majorlongval/first_article_doc/documents_latex/Capstan_drive_ASME/images/3d_print.png

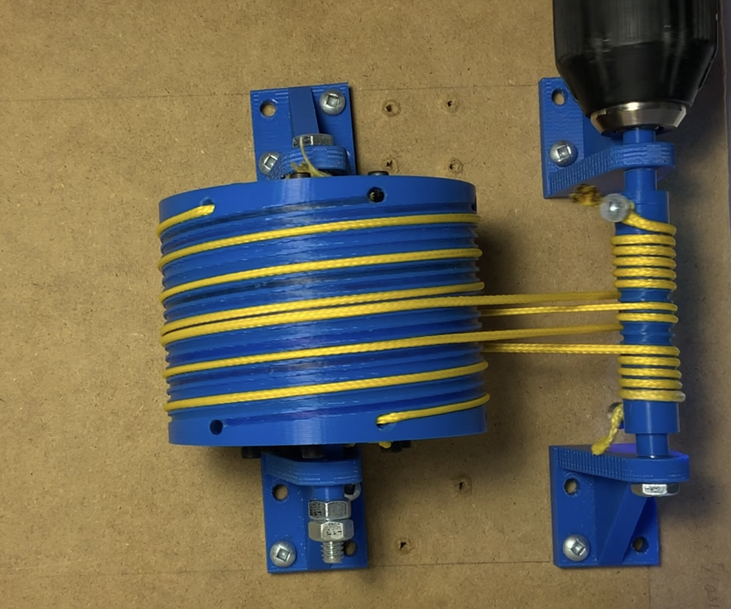
documents_latex/Capstan_drive_ASME/images/3d_print.png
