majorlongval/first_article_doc/documents_latex/Capstan_drive_ASME/images/alt_robot_arch.PNG

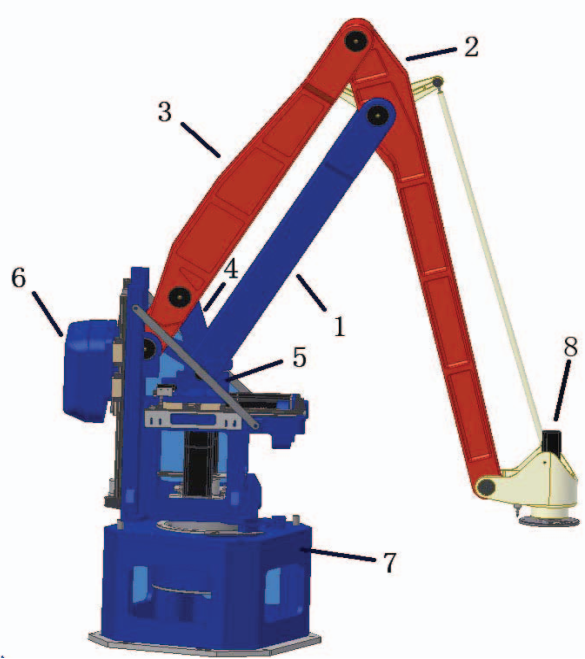
documents_latex/Capstan_drive_ASME/images/alt_robot_arch.PNG
