majorlongval/first_article_doc/documents_latex/Capstan_drive_ASME/images/proto_keifei.PNG

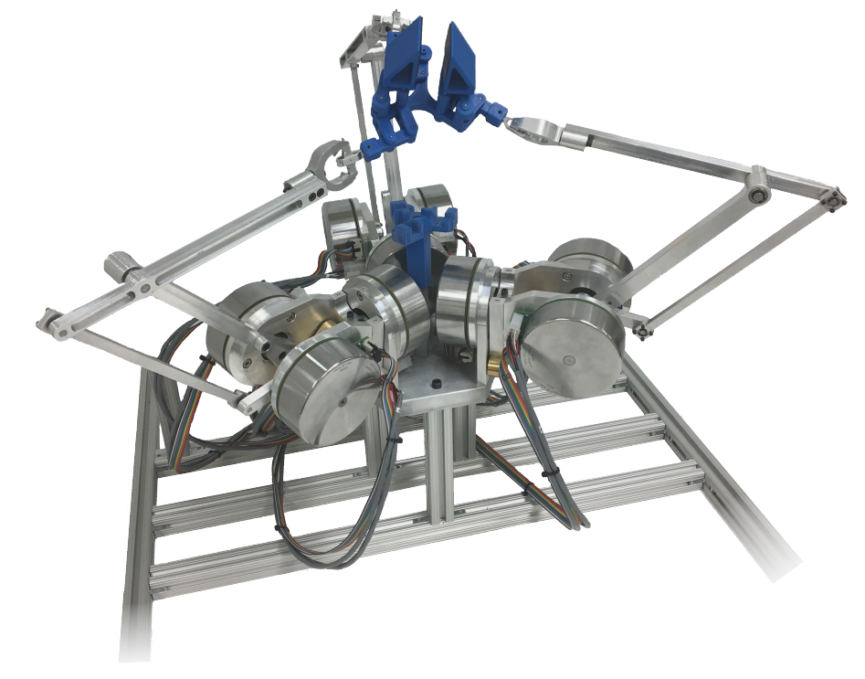
documents_latex/Capstan_drive_ASME/images/proto_keifei.PNG
