majorlongval/first_article_doc/documents_latex/Capstan_drive_ASME/images/wen7-0331-hires.gif

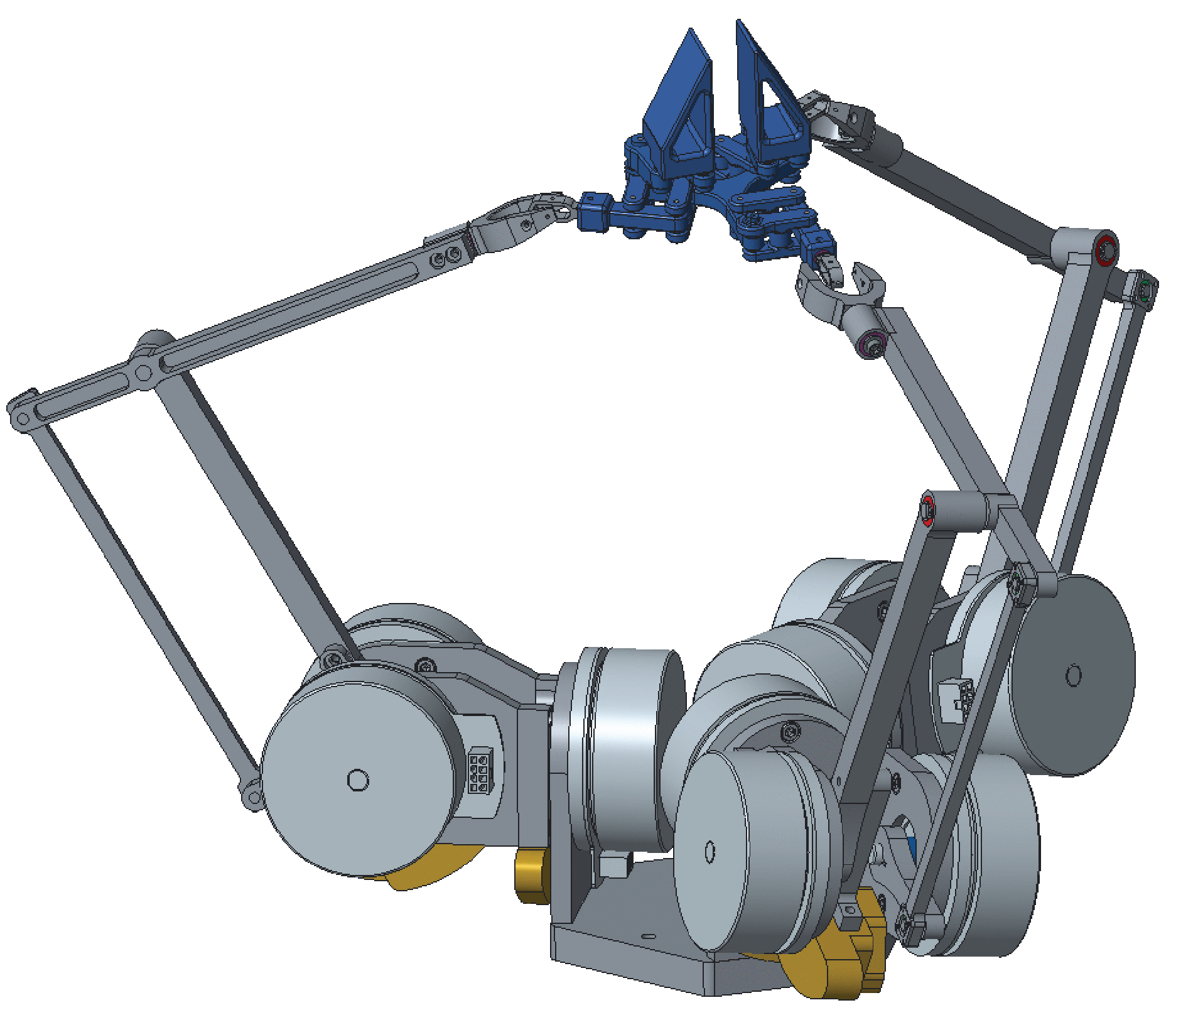
documents_latex/Capstan_drive_ASME/images/wen7-0331-hires.gif
