majorlongval/first_article_doc/CAD_files/rouleau_rainure_simple.stl

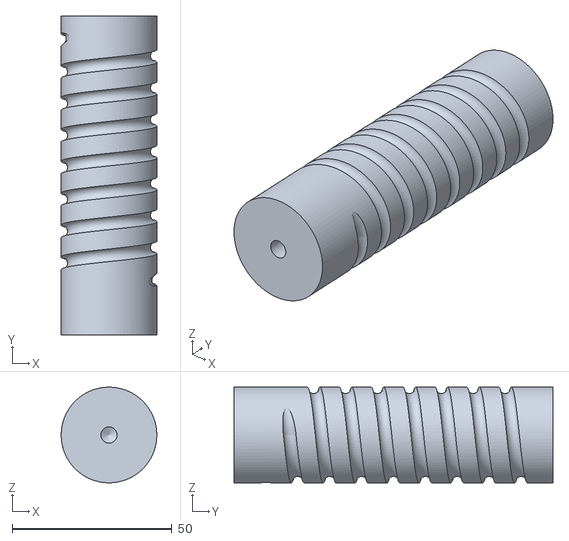
[picture p6: CAD file, 2021-09-30]
CAD_files/rouleau_rainure_simple.stl
30.0 x 100.0 x 30.0
