majorlongval/first_article_doc/CAD_files/rouleau_base_v3.stl

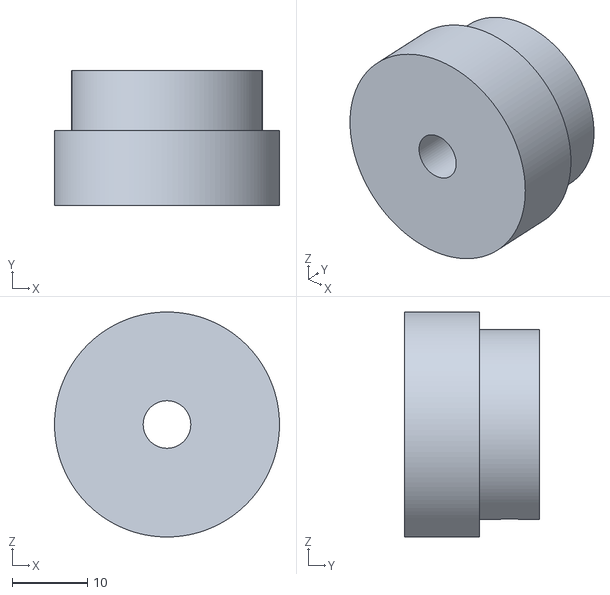
[picture p7: CAD file, 2021-09-30]
CAD_files/rouleau_base_v3.stl
30.0 x 18.0 x 30.0
