majorlongval/first_article_doc/CAD_files/rouleau_rainure_complexe_v2.stl

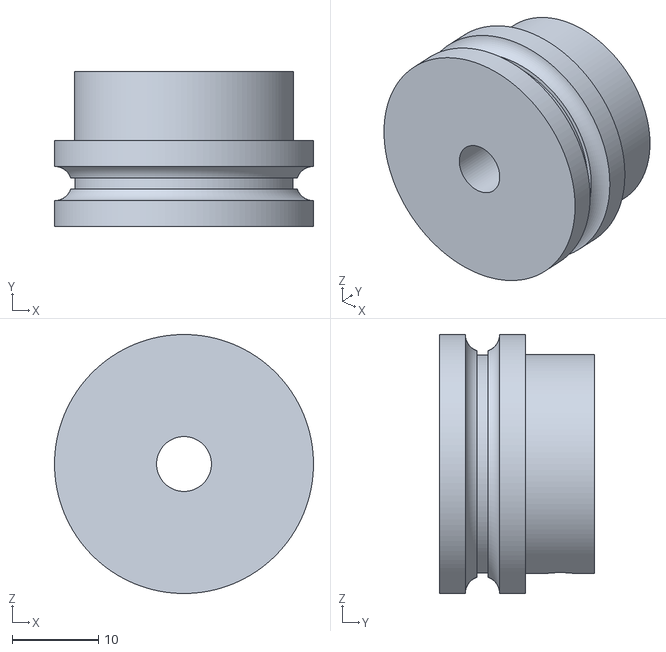
[picture p8: CAD file, 2021-09-30, an earlier design]
CAD_files/rouleau_rainure_complexe_v2.stl
30.0 x 18.0 x 30.0
