majorlongval/first_article_doc/(list of files, cad)

Other CAD files:
CAD_files/rouleau_rainure_complexe_v3.stl
CAD_files/rouleau_base_v2.stl
