majorlongval/first_article_doc/documents_latex/Capstan_drive_ASME/images/experimental_setup.pdf

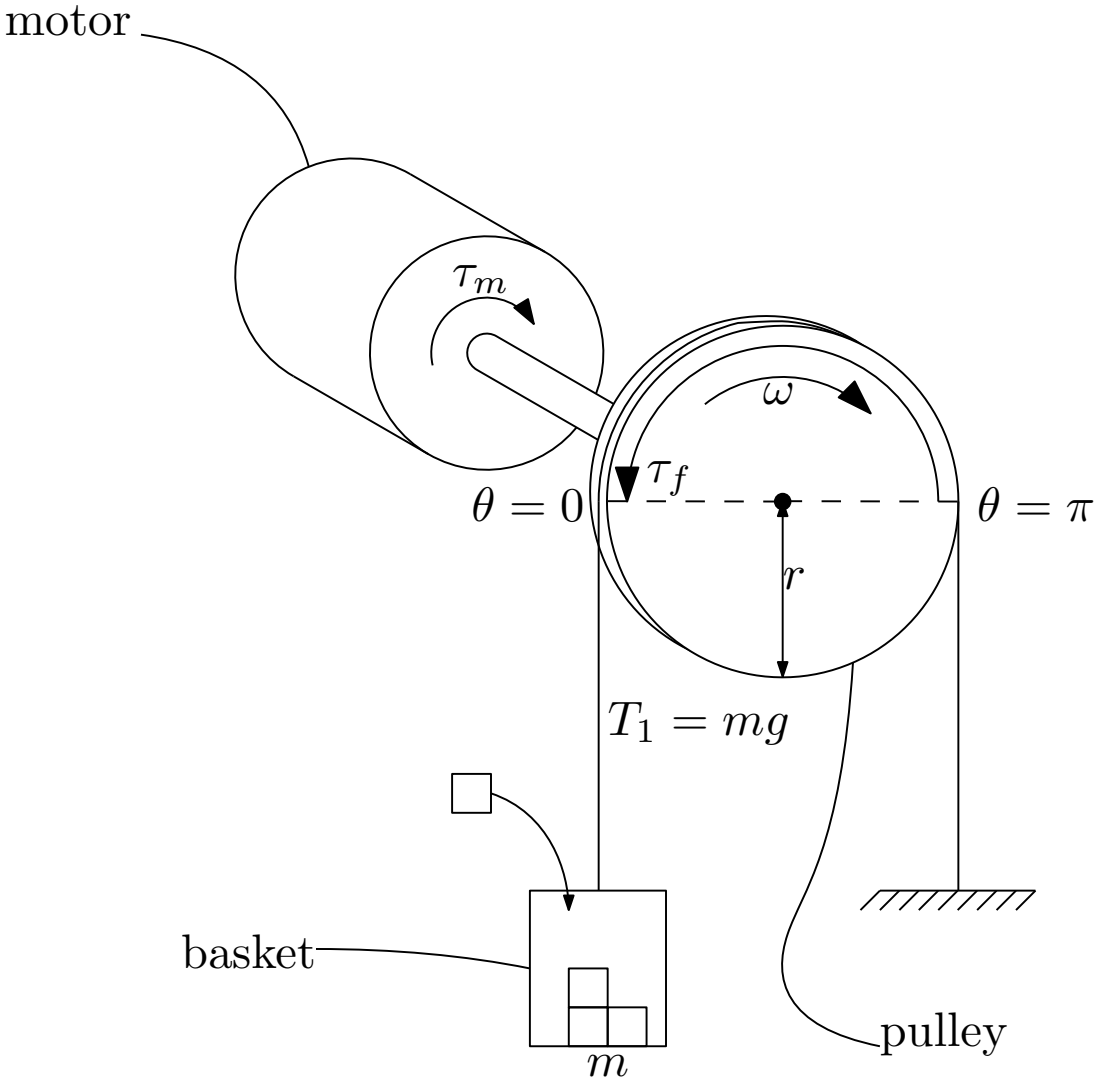
[picture p9: page 1]
motor; pulley r; basket
