majorlongval/first_article_doc/documents_latex/Capstan_drive_RAL/images/experimental_setup.pdf

motor; pulley r; basket
