majorlongval/first_article_doc/documents_latex/dev_cable_crossing/cable_crossing_dev.pdf

# Cable crossing developement

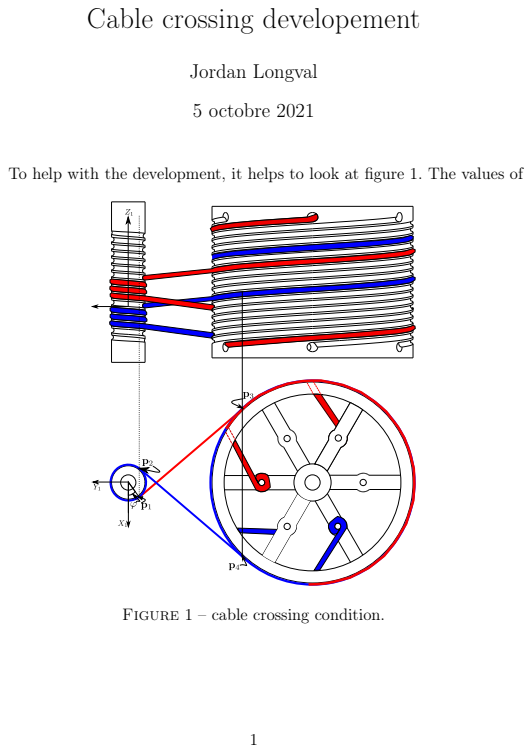
[picture p10: page 1]
Jordan Longval; 5 octobre 2021

To help with the development, it helps to look at figure 1. The values of

Figure 1 – cable crossing condition.

p1 and p2 are given by

p1 =

r1cϕ
−r1sϕ

H1ϕ
2π
- , p2 =

−r1cϕ
−r1sϕ

H1
2π

(3π − ϕ).

- (1)

Also, we know that at points p1 and p2 the unit vectors that are tangeant and that go in the same direction as the cables (towards the large pulley) are expressed respectively as

u1 =

−r1sϕ
−r1cϕ

H1
2π

ρ1

, u2 =

r1s(3π − ϕ)
r1c(3π − ϕ)
−H1
2π

ρ1

=

r1sϕ
−r1cϕ
−H1
2π

ρ1

. | (2)

With the expressions in (1) and (2), we can express the positions of p3 and p4 respectively as

p3 = p1 + Lfu1, | (3)
p4 = p2 + Lfu2. | (4)

The line l1 that passes through p1 and p2 can be expressed with the form

l1 : p(s1) = p1 + (p3 − p1)s1, | s1 ∈ R, | (5)

where s1 is an arbitrary parameter. In the same manner, the line l2 that passes through points p3 and p4 can be expressed with the form

l2 : p(s2) = p2 + (p4 − p2)s2, | s2 ∈ R, | (6)

where s2 is also an arbitrary parameter. The expressions in equations (5) and
(6) can be further simplified to
l1 : p(s1) = p1 + Lf s1u1, | l2 : p(s2) = p2 + Lf s2u2. | (7)

The shortest distance d between l1 and l2 is given by the following equation

d = L

2
f

u1 × u2
ku1 × u2k
- (p2 − p1). | (8)

L

2
f =

ρ

2/1(D² − (r2 + r1)

2
)
r

2
1

(9)

u1 × u2 =

1
ρ

2
1

−r1sϕ
−r1cϕ

H1
2π
- ×

r1sϕ
−r1cϕ
−H1
2π
- =

2r1cϕ
ρ

2
1

H1
2π
0
r1sϕ
- (10)
ku1 × u2k = | (11)

2
