majorlongval/first_article_doc/documents_latex/Capstan_drive_ASME/images/steps-eps-converted-to.pdf

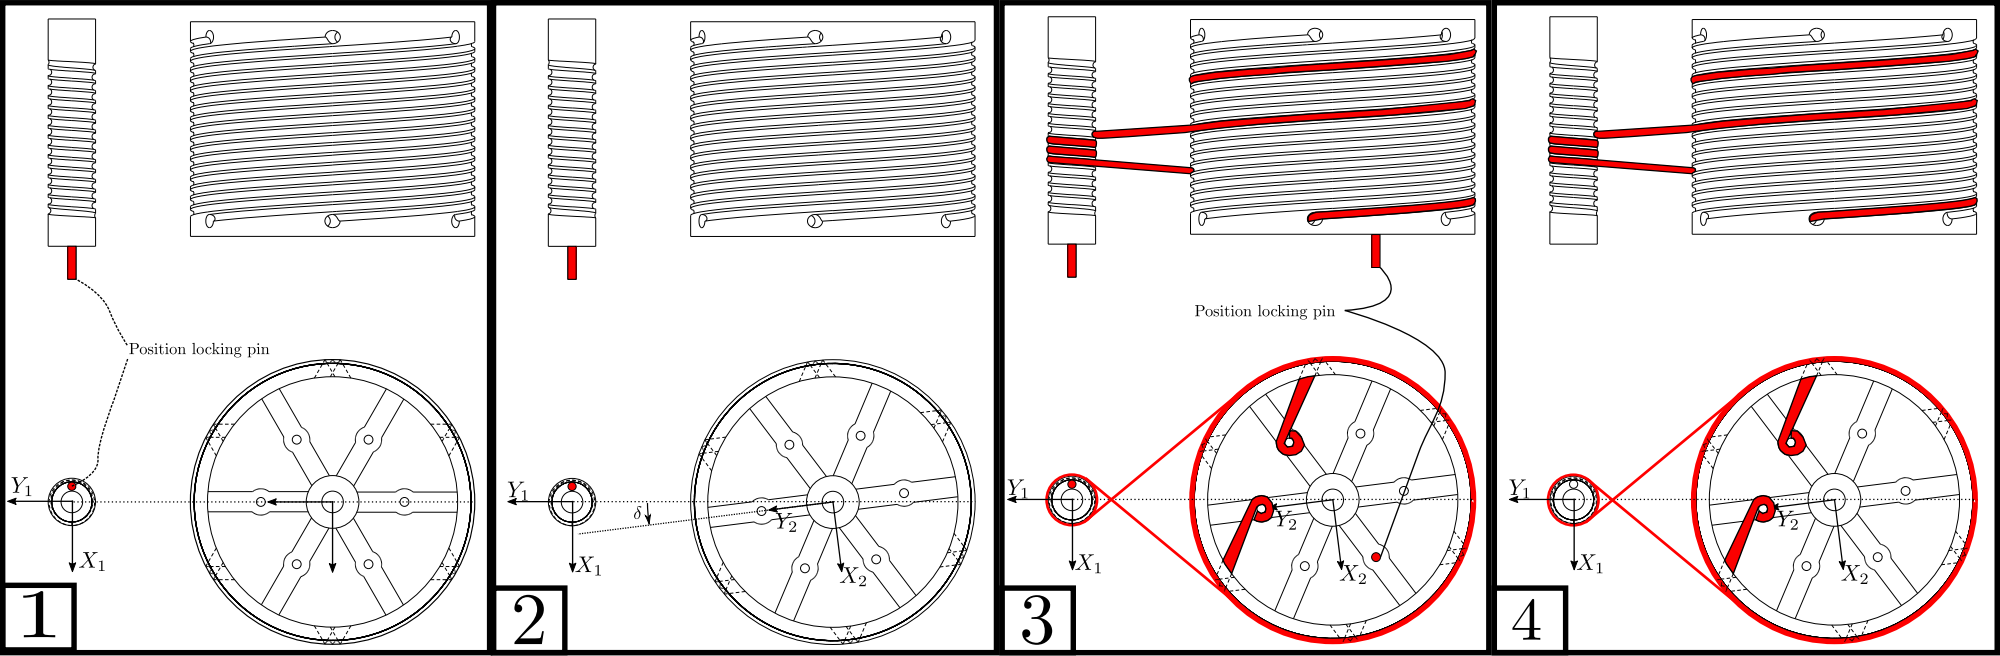
[picture p11: page 1]
