majorlongval/first_article_doc/documents_latex/Capstan_drive_ASME/images/test_print_poulies-eps-converted-to.pdf

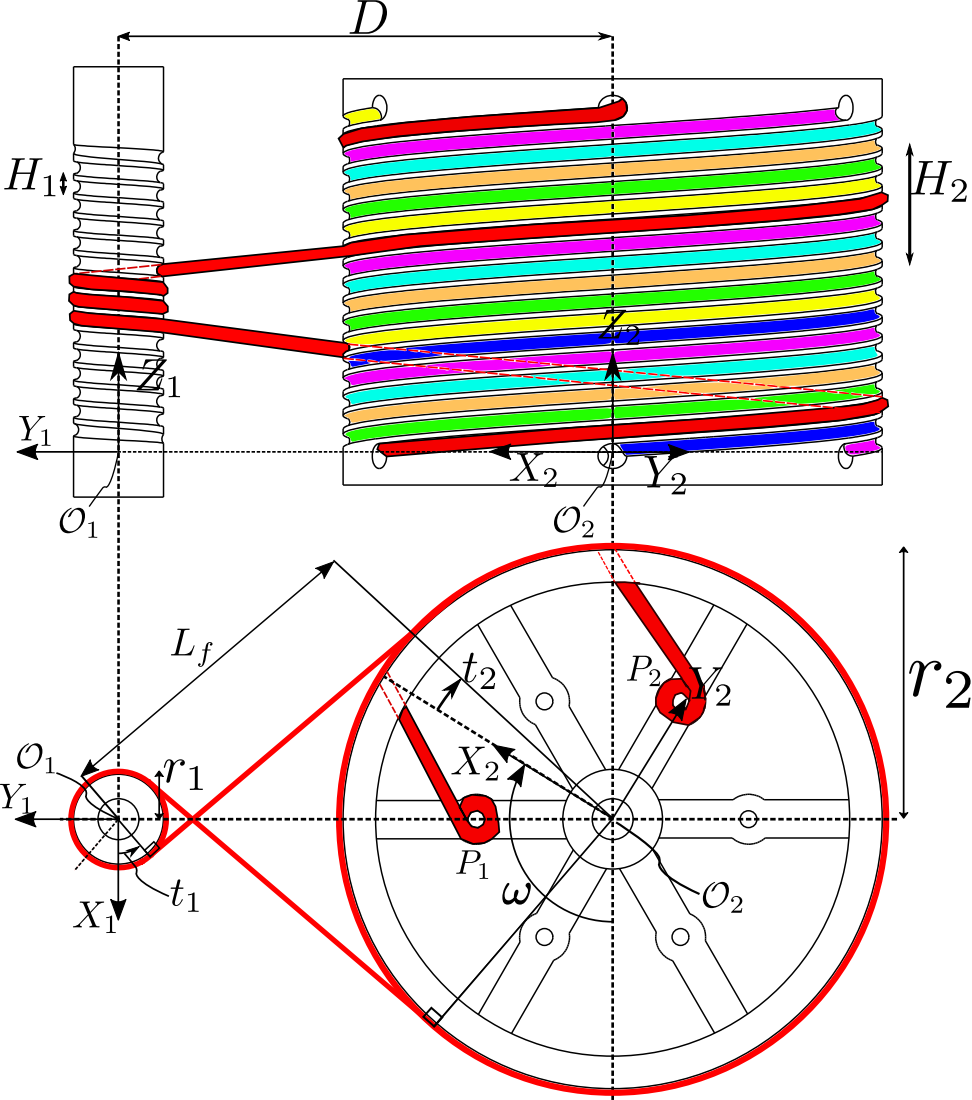
[picture p12: page 1]
