majorlongval/first_article_doc/documents_latex/dev_cable_crossing/fig_1.pdf

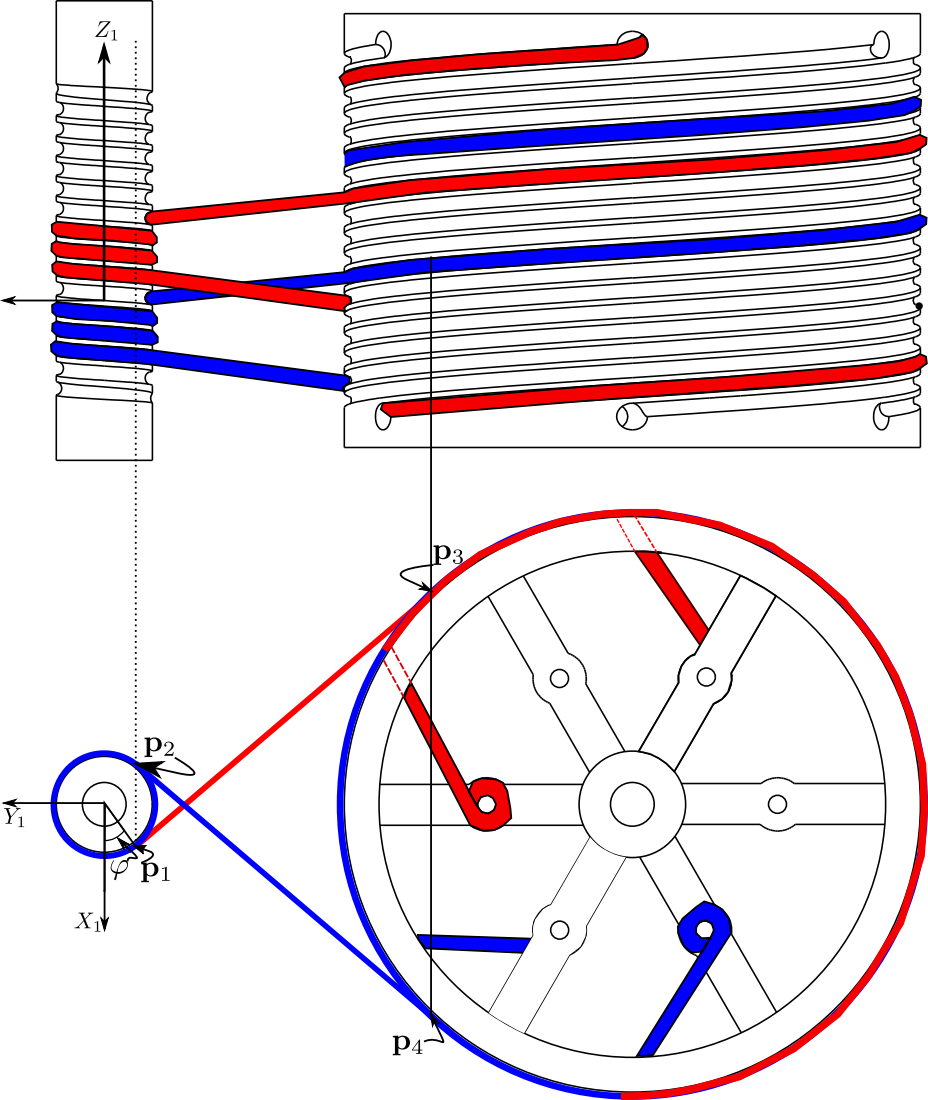
[picture p13: page 1]
