majorlongval/first_article_doc/documents_latex/Capstan_drive_ASME/images/fig_exp.pdf

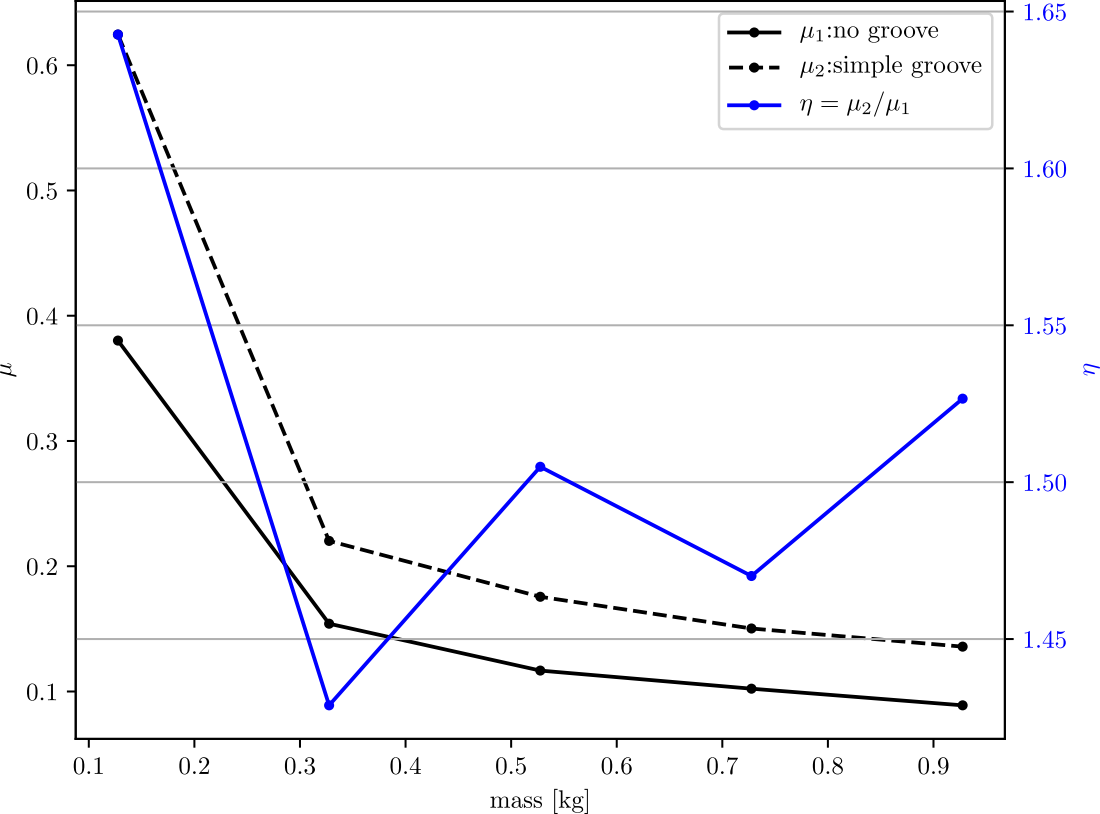
[picture p14: page 1]
