majorlongval/first_article_doc/documents_latex/Capstan_drive_RAL/images/two_cables_multi_loops-eps-converted-to.pdf

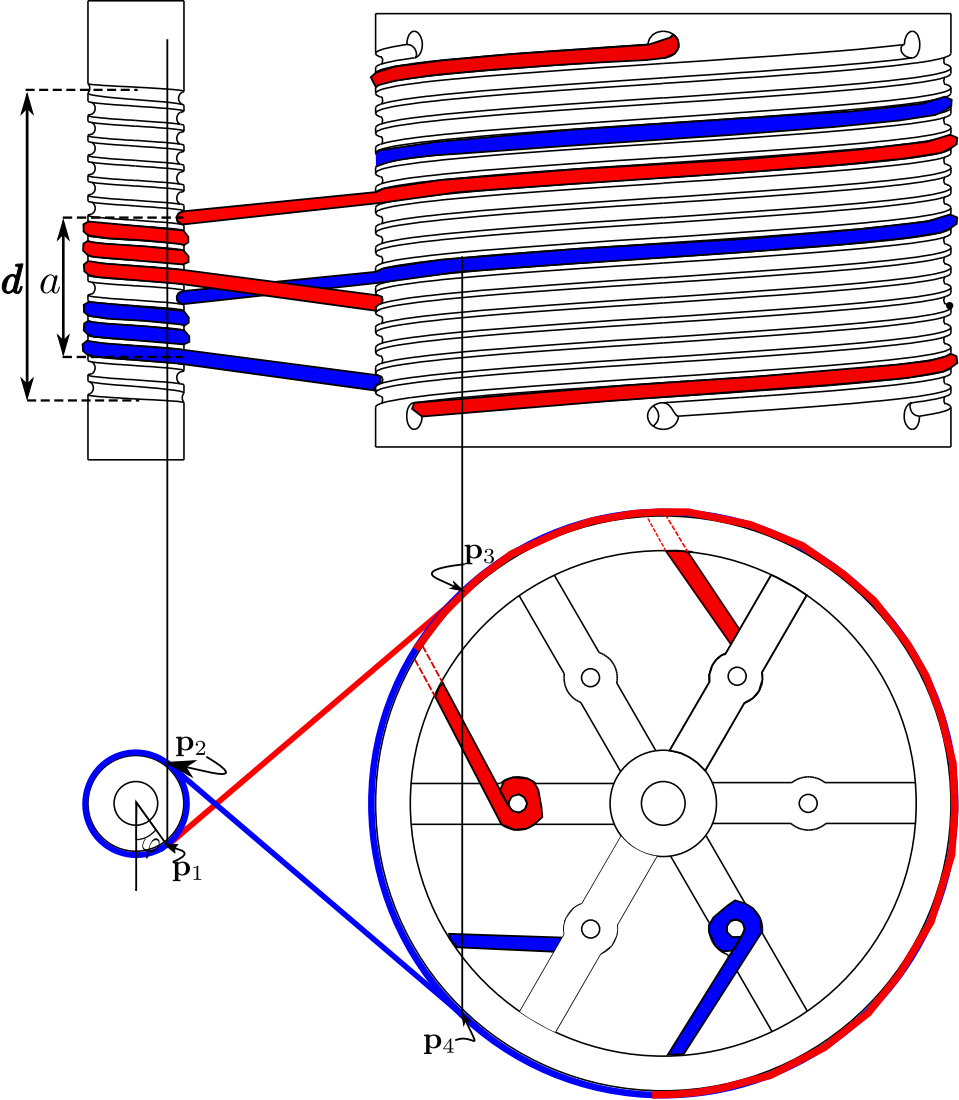
[picture p15: page 1]
