majorlongval/first_article_doc/documents_latex/Capstan_drive_ASME/images/capstan_equation-eps-converted-to.pdf

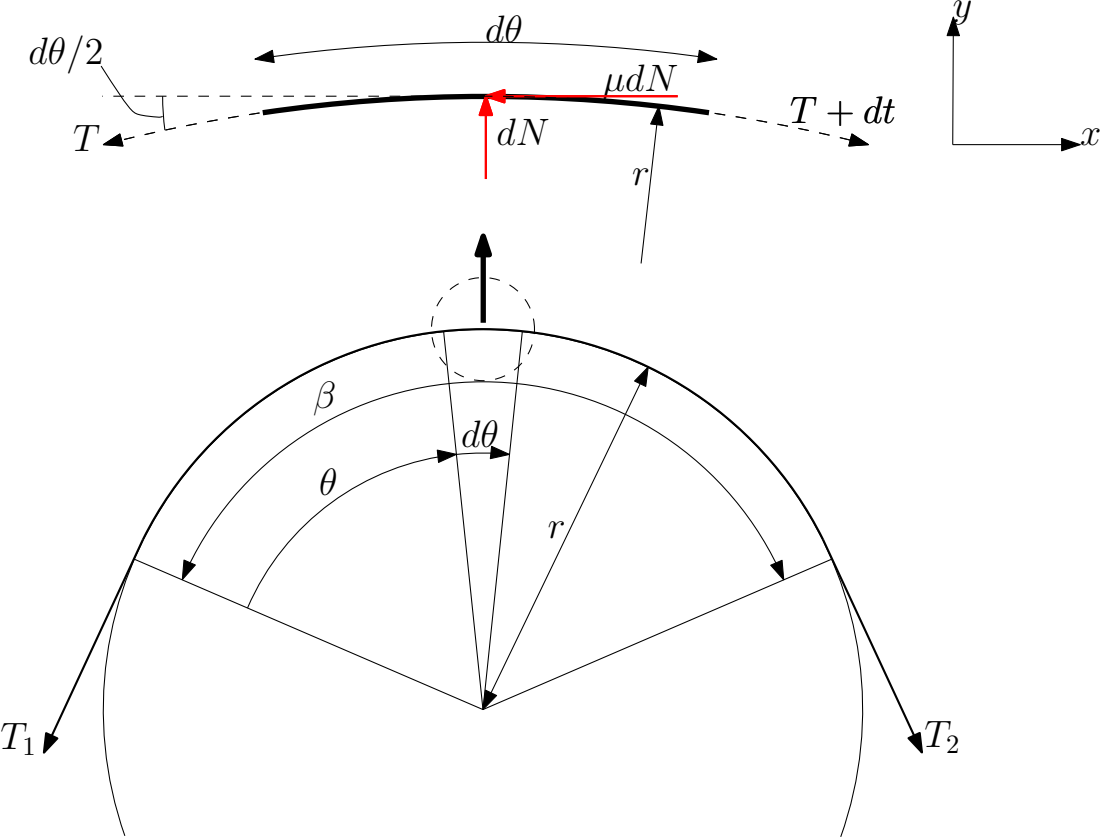
[picture p16: page 1]
µdN
