majorlongval/first_article_doc/documents_latex/Capstan_drive_ASME/images/distribution_de_force_cable-eps-converted-to.pdf

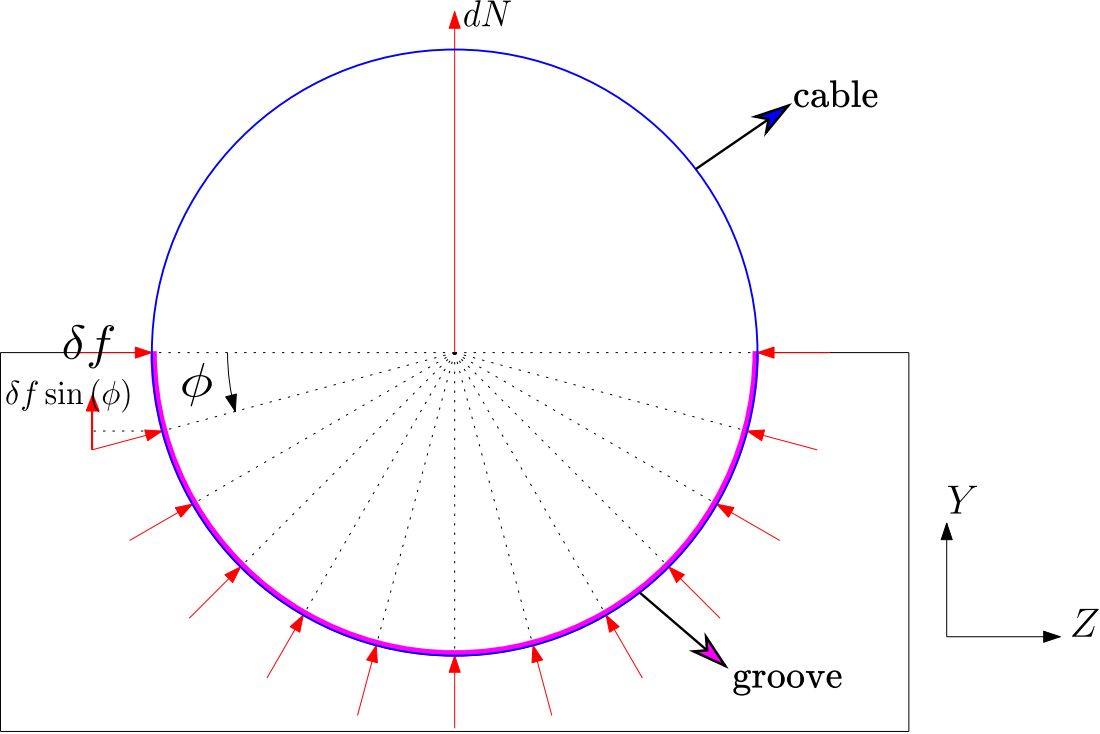
[picture p17: page 1]
