majorlongval/first_article_doc/documents_latex/Capstan_drive_ASME/images/distribution_tension_gen-eps-converted-to.pdf

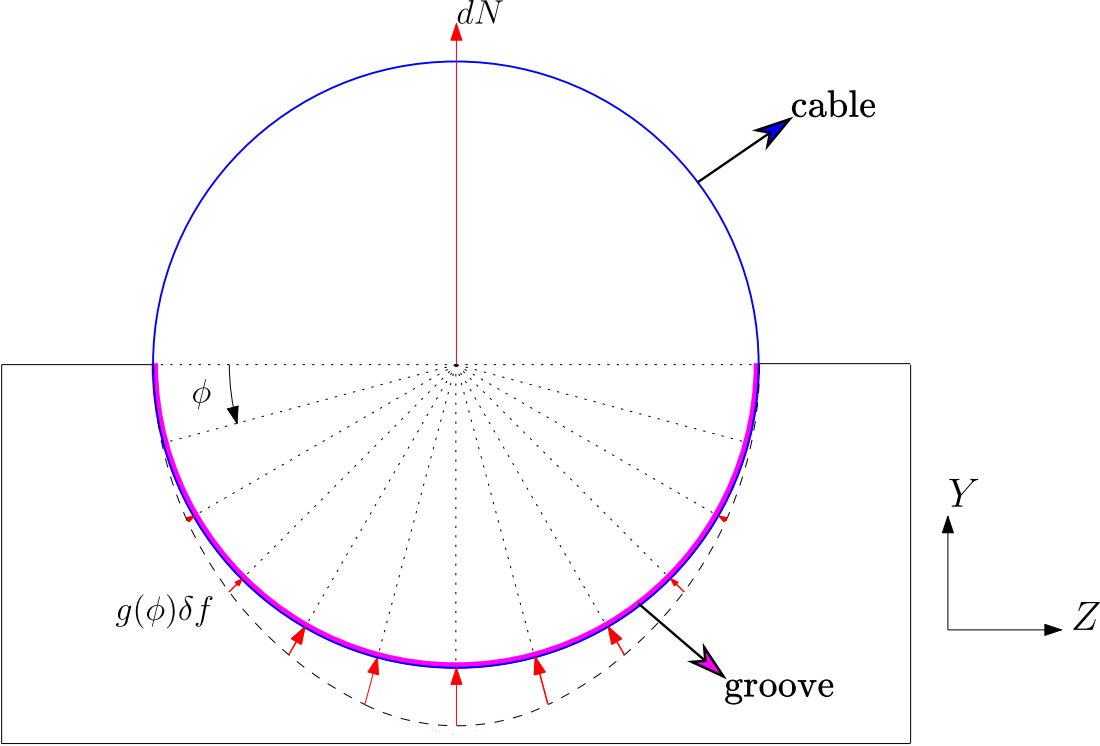
[picture p18: page 1]
