majorlongval/first_article_doc/documents_latex/Capstan_drive_ASME/images/modelling_of_capstan_drive-eps-converted-to.pdf

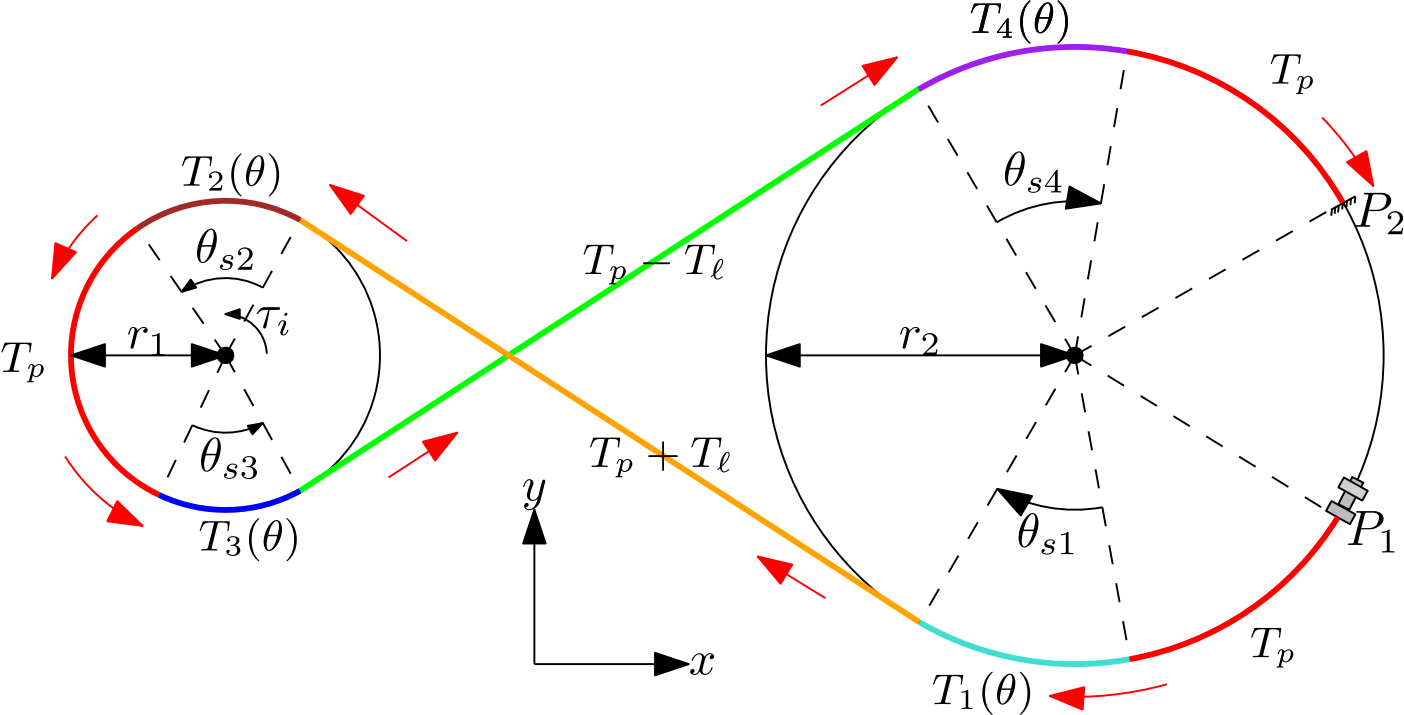
[picture p19: page 1]
