majorlongval/first_article_doc/documents_latex/Capstan_drive_ASME/images/only_one_cable_multi_loops-eps-converted-to.pdf

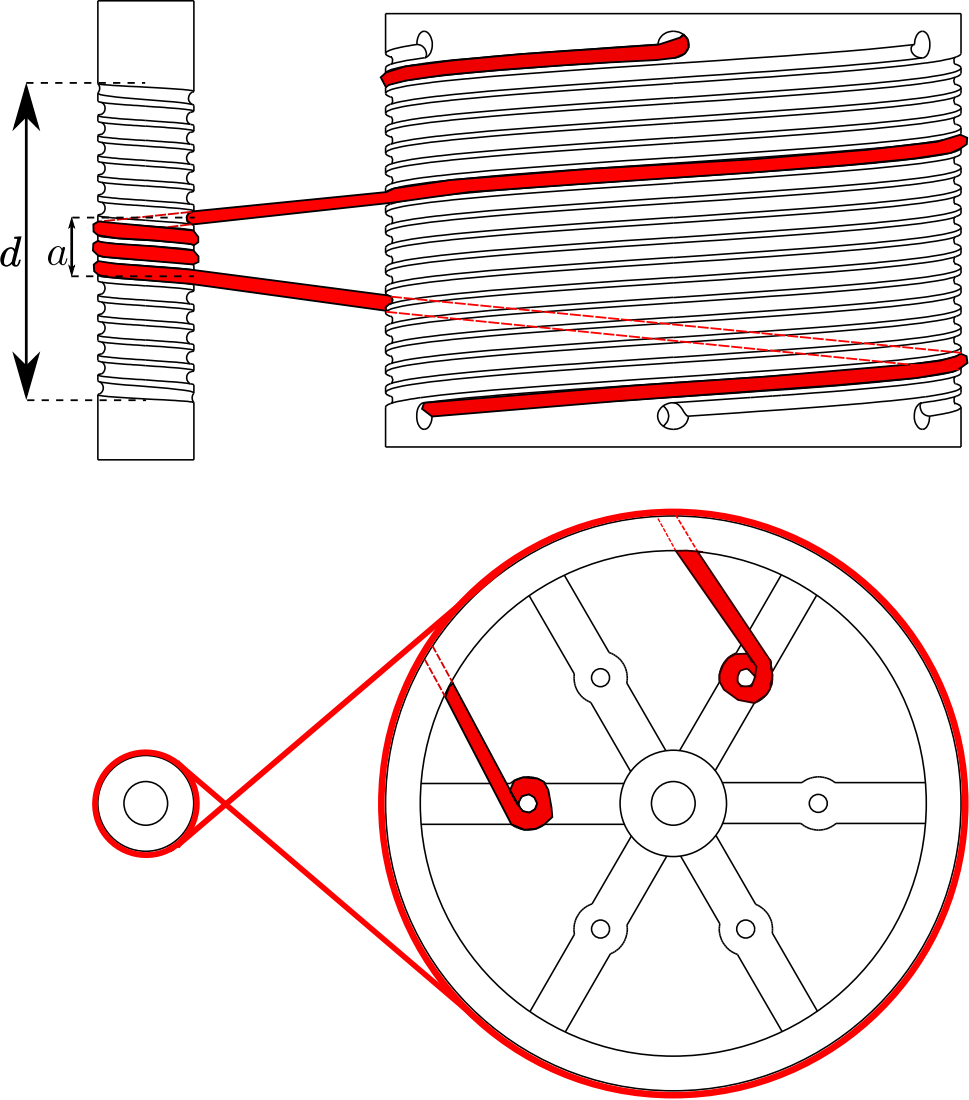
[picture p20: page 1]
