majorlongval/first_article_doc/documents_latex/Capstan_drive_ASME/images/three_cables_multi_loops-eps-converted-to.pdf

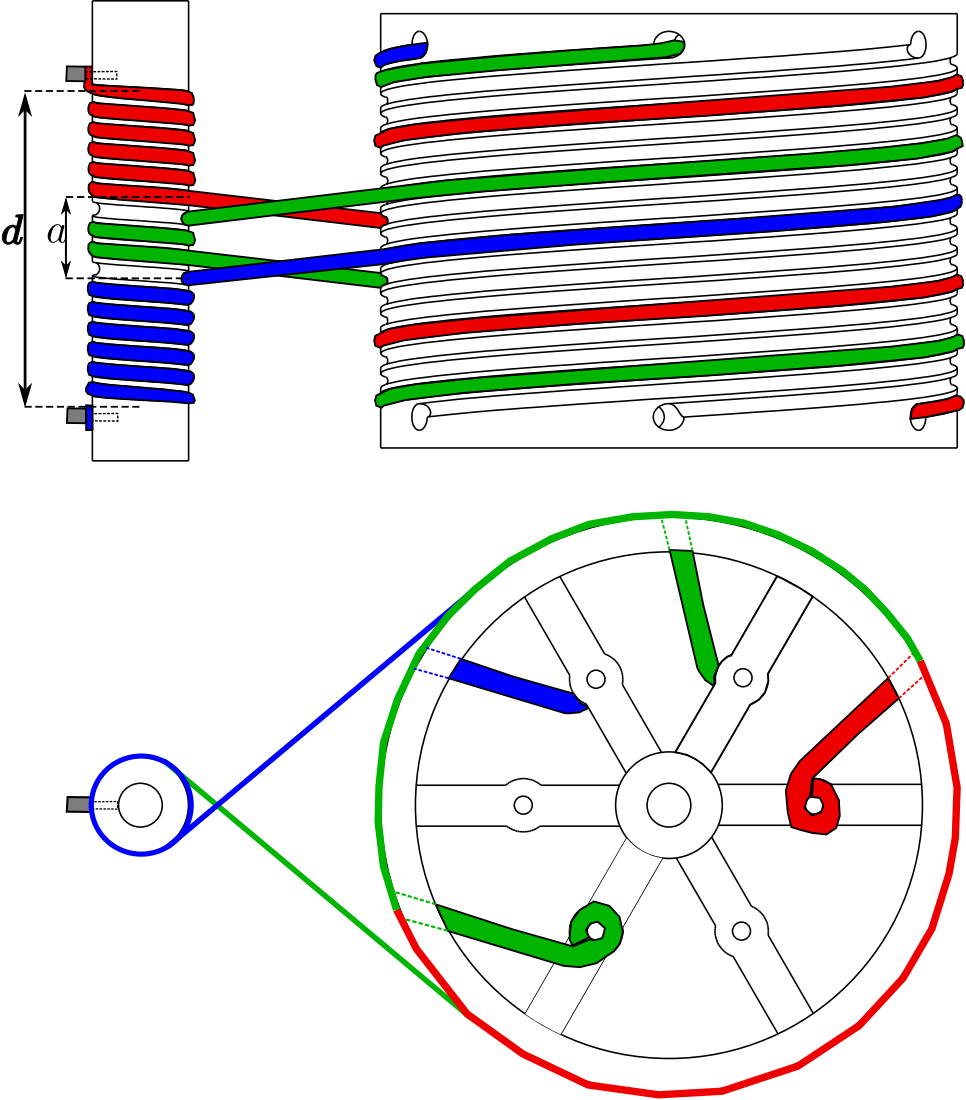
[picture p21: page 1]
