majorlongval/first_article_doc/documents_latex/Capstan_drive_ASME/images/two_cables_all_loops-eps-converted-to.pdf

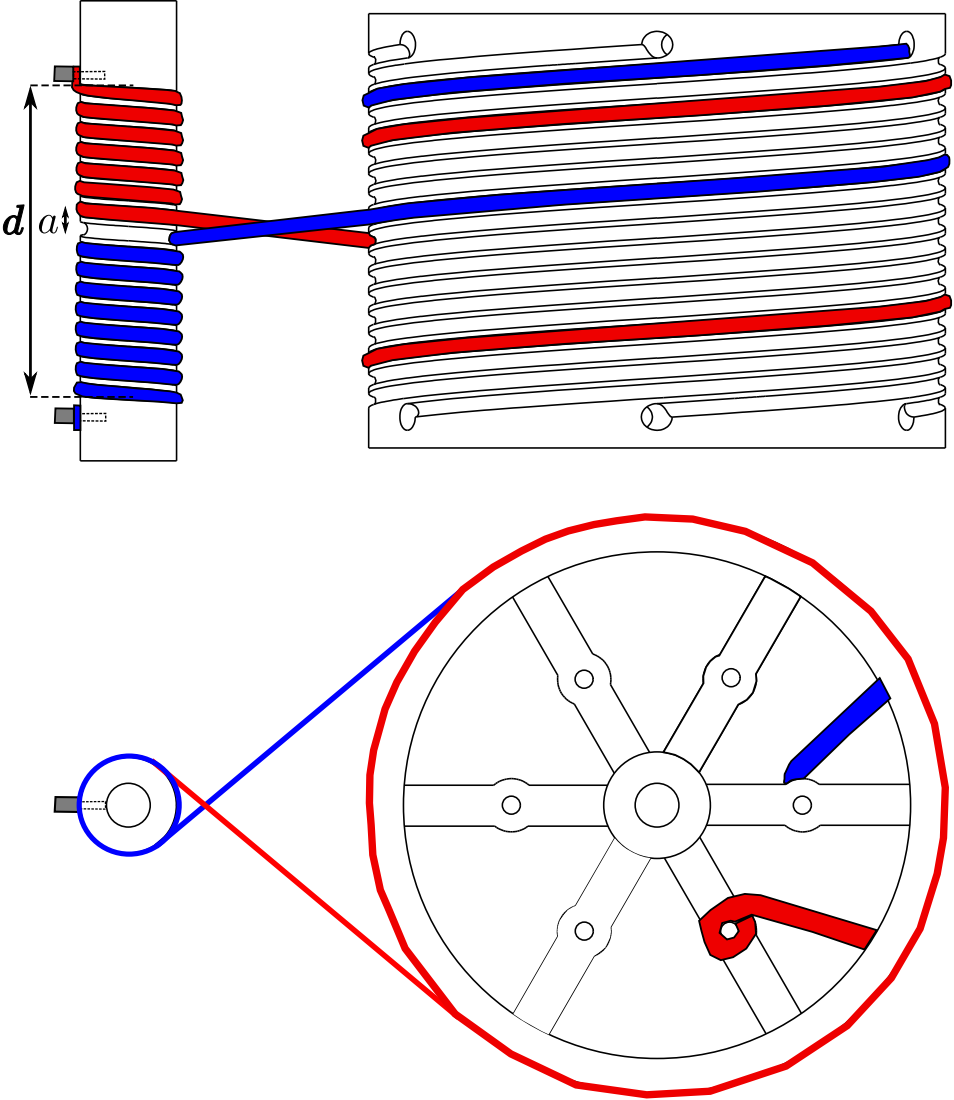
[picture p22: page 1]
