majorlongval/first_article_doc/documents_latex/Capstan_drive_ASME/images/two_cables_multi_loops-eps-converted-to.pdf

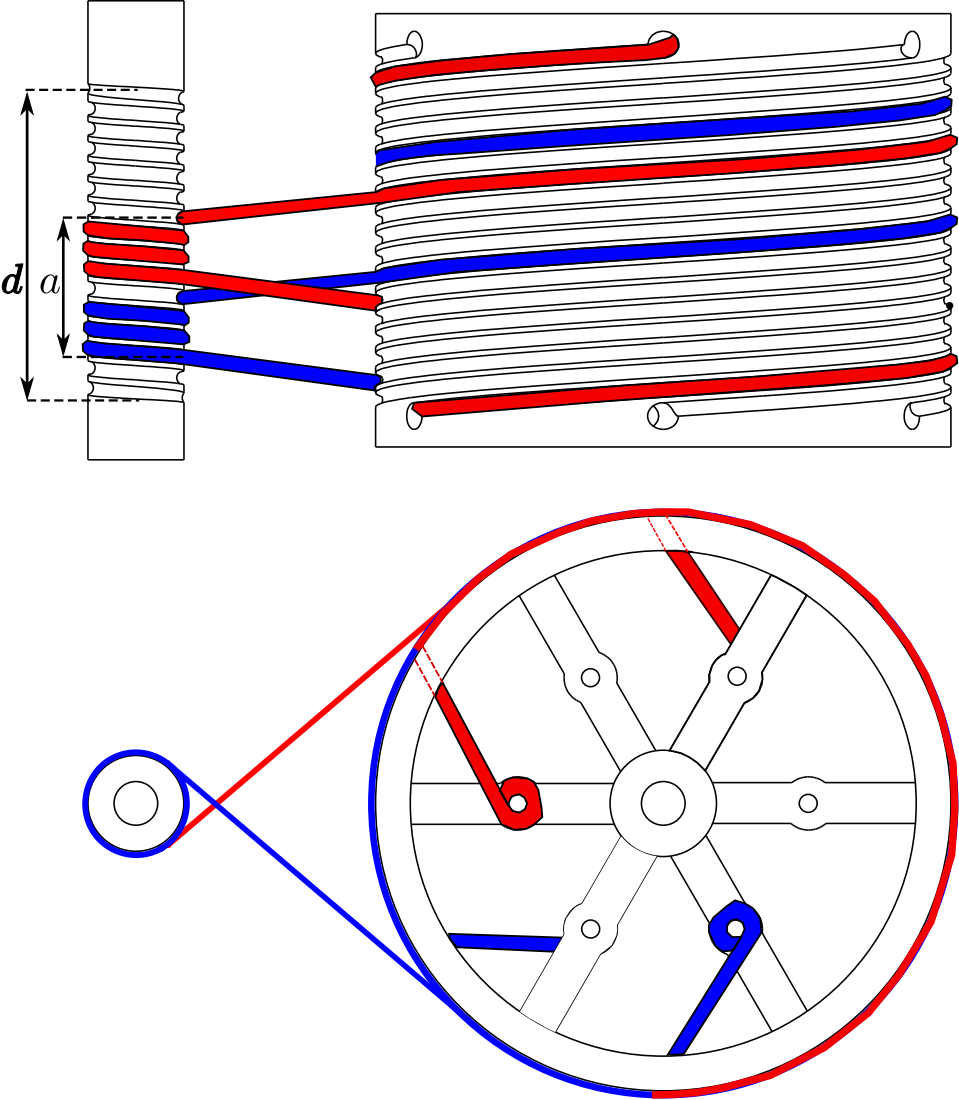
[picture p23: page 1]
