majorlongval/first_article_doc/(commit log)

2021-09-30 Adding the files for the first article. Will add more later.
    [altsf.cfg, ltxdoc.cfg, rouleau_base_v2.stl, rouleau_base_v3.stl, rouleau_rainure_complexe_v2.stl, rouleau_rainure_complexe_v3.stl, rouleau_rainure_simple.stl, rouleau_rainure_simple_v2.stl]
2021-09-30 Added the code folder
    [data.csv]
