majorlongval/first_article_doc/(notices)

Notices in the files:
documents_latex/Capstan_drive_RAL/On_the_synthesis_and_design_of_a_novel_backdrivable_high-stiffness_capstan_drive.tex:
This work is distributed under the LaTeX Project Public License (LPPL)
